munz74/HVSC_KICAD/HVSC5.stp

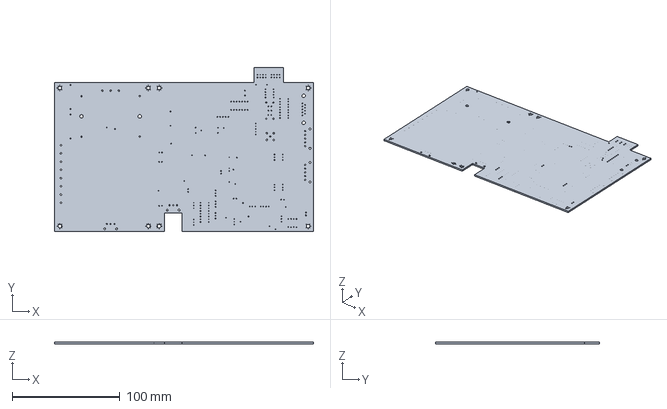
[picture p1: CAD file, 2018-07-04]
HVSC5.stp
240.0 x 152.0 x 1.60 mm
