munz74/HVSC_KICAD/HVSC5.kicad_pcb

## KiCad design HVSC5.kicad_pcb (2018-07-23)

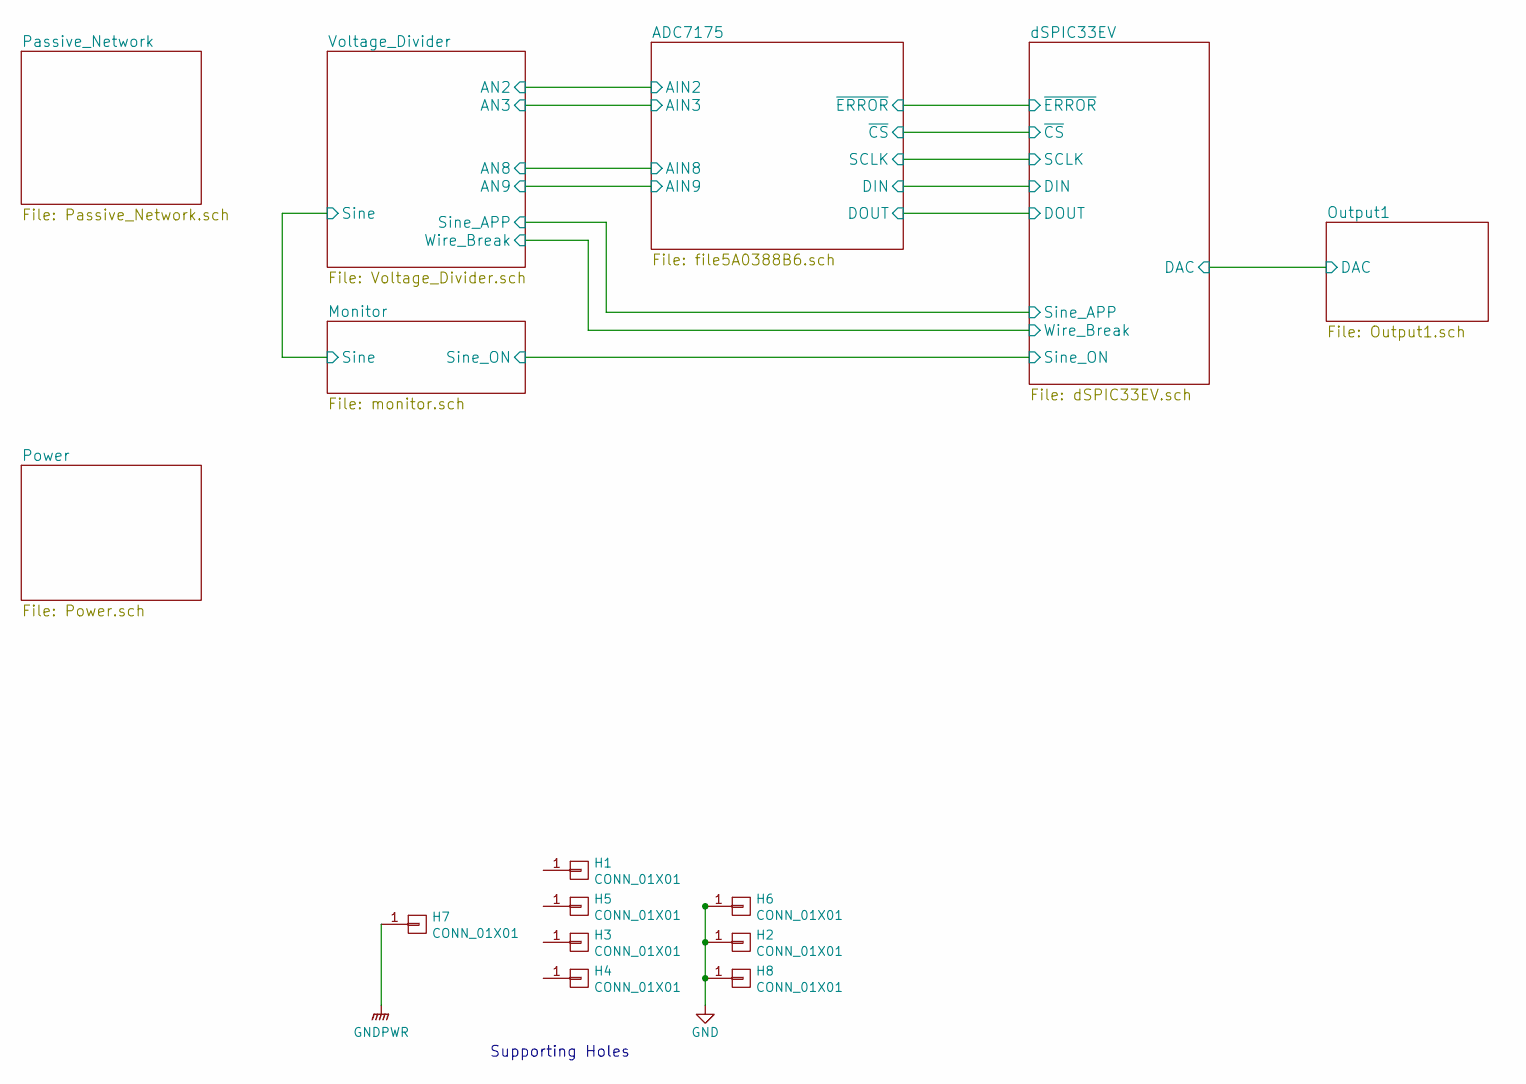
[picture p2: schematic HVSC5.sch]

Parts:
H1, H2, H3, H4, H5, H6, H7, H8: CONN_01X01; MountingHole_3.2mm_M3_Pad_Via

Connections:
GND: H2.1, H6.1, H8.1; also elsewhere on the board
GNDPWR: H7.1; also elsewhere on the board

Notes on the sheet:
Supporting Holes

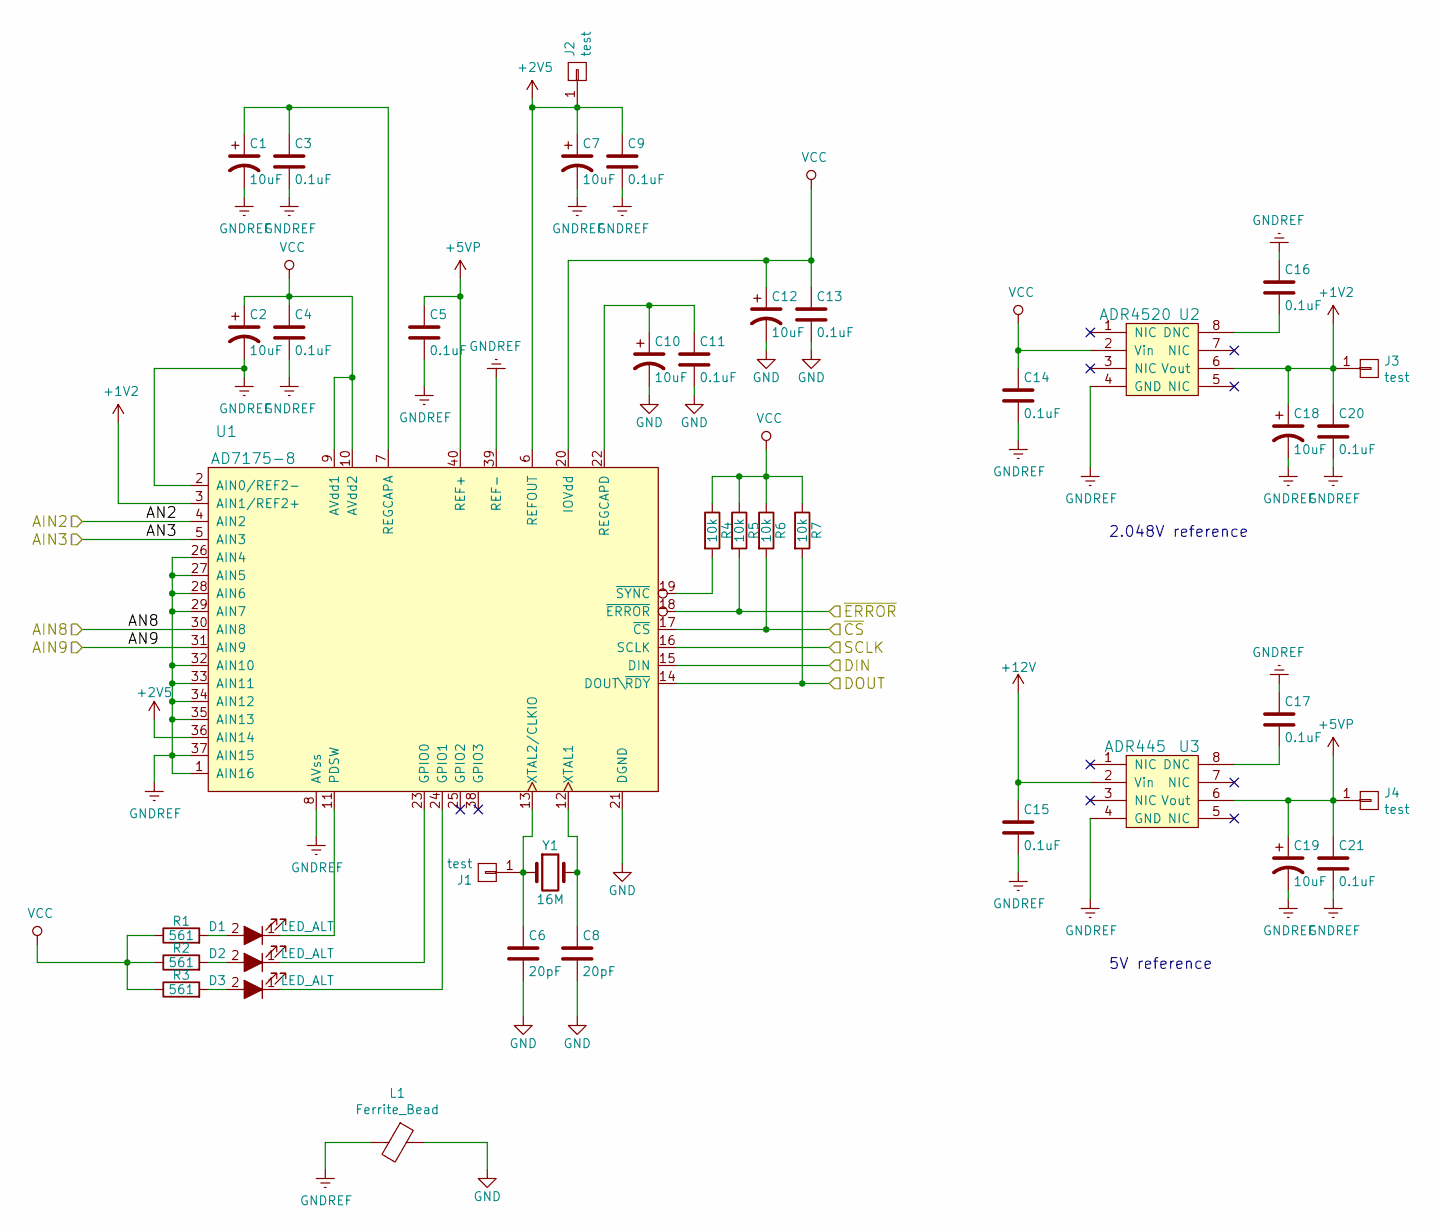
[picture p3: schematic file5A0388B6.sch]

Parts:
C1, C2, C7, C10, C12, C18, C19: 10uF; C_1812_HandSoldering_Polar
C3, C4, C5, C9, C11, C13, C14, C15, C16, C17, C20, C21: 0.1uF; C_0805_HandSoldering
C6, C8: 20pF; C_0805_HandSoldering
D1, D2, D3: LED_ALT; LED_0805_HandSoldering
J1, J2, J3, J4: test; Pin_Header_Straight_1x01_Pitch2.00mm
L1: Ferrite_Bead; L_1806_Handsoldering
R1, R2, R3: 561; R_0805_HandSoldering
R4, R5, R6, R7: 10k; R_0805_HandSoldering
U1: AD7175-8; LFCSP-40-1EP_long
U2: ADR4520; SOIC-8_3.9x4.9mm_Pitch1.27mm
U3: ADR445; SOIC-8_3.9x4.9mm_Pitch1.27mm
Y1: 16M; Crystal_HC49-4H_Vertical

Connections:
+1V2: C18.1, C20.1, J3.1, U1.3 (AIN1/REF2+), U2.6 (Vout)
+2V5: C7.1, C9.1, J2.1, U1.6 (REFOUT), U1.36 (AIN14); also elsewhere on the board
+5VP: C5.1, C19.1, C21.1, J4.1, U1.40 (REF+), U3.6 (Vout)
+12V: C15.1, U3.2 (Vin); also elsewhere on the board
/ADC7175/AIN2: U1.4 (AIN2); also elsewhere on the board
/ADC7175/AIN3: U1.5 (AIN3); also elsewhere on the board
/ADC7175/AIN8: U1.30 (AIN8); also elsewhere on the board
/ADC7175/AIN9: U1.31 (AIN9); also elsewhere on the board
/ADC7175/DIN: U1.15 (DIN); also elsewhere on the board
/ADC7175/DOUT: R7.2, U1.14 (DOUT\~RDY); also elsewhere on the board
/ADC7175/SCLK: U1.16 (SCLK); also elsewhere on the board
/ADC7175/~CS: R6.2, U1.17 (~CS); also elsewhere on the board
/ADC7175/~ERROR: R5.2, U1.18 (~ERROR); also elsewhere on the board
GND: C6.2, C8.2, C10.2, C11.2, C12.2, C13.2, L1.1, U1.21 (DGND); also elsewhere on the board
GNDREF: C1.2, C2.2, C3.2, C4.2, C5.2, C7.2, C9.2, C14.2, C15.2, C16.1, C17.1, C18.2, C19.2, C20.2, C21.2, L1.2, U1.1 (AIN16), U1.2 (AIN0/REF2-), U1.8 (AVss), U1.26 (AIN4), U1.27 (AIN5), U1.28 (AIN6), U1.29 (AIN7), U1.32 (AIN10), U1.33 (AIN11), U1.34 (AIN12), U1.35 (AIN13), U1.37 (AIN15), U1.39 (REF-), U2.4 (GND), U3.4 (GND); also elsewhere on the board
unnamed: C1.1, C3.1, U1.7 (REGCAPA)
unnamed: C6.1, J1.1, U1.13 (XTAL2/CLKIO), Y1.1
unnamed: C8.1, U1.12 (XTAL1), Y1.2
unnamed: C10.1, C11.1, U1.22 (REGCAPD)
unnamed: C16.2, U2.8 (DNC)
unnamed: C17.2, U3.8 (DNC)
unnamed: D1.1 (K), U1.11 (PDSW)
unnamed: D1.2 (A), R1.2
unnamed: D2.1 (K), U1.23 (GPIO0)
unnamed: D2.2 (A), R2.2
unnamed: D3.1 (K), U1.24 (GPIO1)
unnamed: D3.2 (A), R3.2
unnamed: R4.2, U1.19 (~SYNC)
VCC: C2.1, C4.1, C12.1, C13.1, C14.1, R1.1, R2.1, R3.1, R4.1, R5.1, R6.1, R7.1, U1.9 (AVdd1), U1.10 (AVdd2), U1.20 (IOVdd), U2.2 (Vin); also elsewhere on the board

Notes on the sheet:
5V reference
2.048V reference

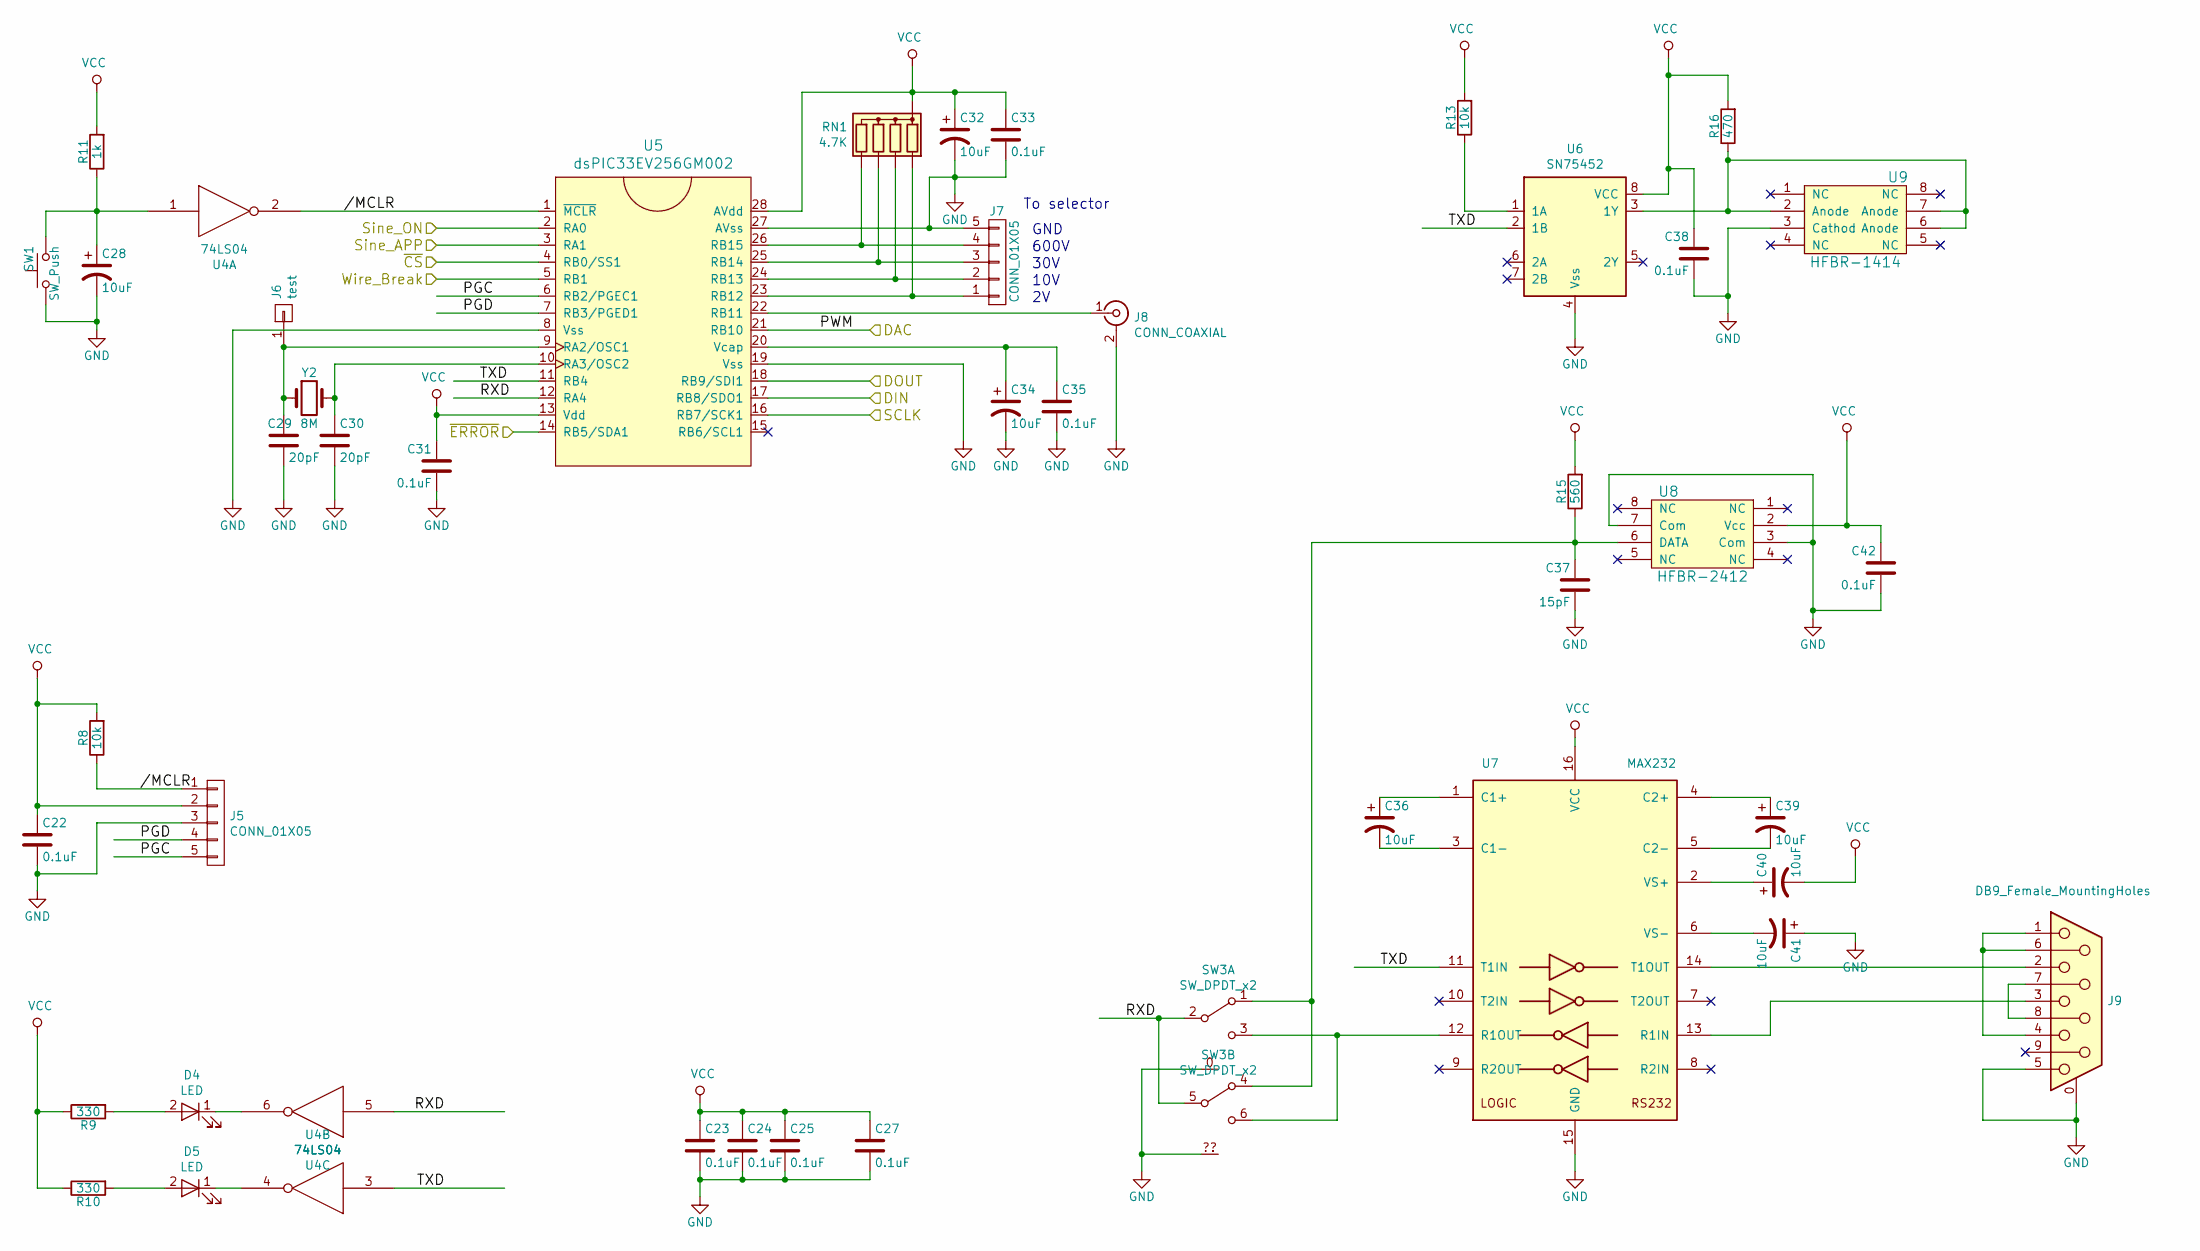
[picture p4: schematic dSPIC33EV.sch]

Parts:
C22, C23, C24, C25, C27, C31, C33, C35, C38, C42: 0.1uF; C_0805_HandSoldering
C28, C32, C34, C36, C39, C40, C41: 10uF; C_1812_HandSoldering_Polar
C29, C30: 20pF; C_0805_HandSoldering
C37: 15pF; C_0805_HandSoldering
D4, D5: LED; LED_D5.0mm
J5: CONN_01X05; Pin_Header_Straight_1x05_Pitch2.54mm
J6: test; Pin_Header_Straight_1x01_Pitch2.00mm
J7: CONN_01X05; M53259-5
J8: CONN_COAXIAL; bnc-ci
J9: DB9_Female_MountingHoles; DB_9F
R8, R13: 10k; R_0805_HandSoldering
R9, R10: 330; R_0805_HandSoldering
R11: 1k; R_0805_HandSoldering
R15: 560; R_0805_HandSoldering
R16: 470; R_Axial_DIN0207_L6.3mm_D2.5mm_P10.16mm_Horizontal
RN1: 4.7K; R_Array_SIP5
SW1: SW_Push; SW_Tactile_SPST_PTS645Vx58-2
SW3: SW_DPDT_x2; SW_E-Switch_EG2219_DPDT
U4: 74LS04; DIP-14_W7.62mm_Socket
U5: dsPIC33EV256GM002; SSOP-28_5.3x10.2mm_Pitch0.65mm
U6: SN75452; DIP-8_W7.62mm
U7: MAX232; DIP-16_W7.62mm
U8: HFBR-2412; HFBR-1414
U9: HFBR-1414
Y2: 8M; Crystal_HC49-4H_Vertical

Connections:
/ADC7175/DIN: U5.17 (RB8/SDO1); also elsewhere on the board
/ADC7175/DOUT: U5.18 (RB9/SDI1); also elsewhere on the board
/ADC7175/SCLK: U5.16 (RB7/SCK1); also elsewhere on the board
/ADC7175/~CS: U5.4 (RB0/SS1); also elsewhere on the board
/ADC7175/~ERROR: U5.14 (RB5/SDA1); also elsewhere on the board
/Monitor/Sine_ON: U5.2 (RA0); also elsewhere on the board
/Output1/DAC: U5.21 (RB10); also elsewhere on the board
/Voltage_Divider/Sine_APP: U5.3 (RA1); also elsewhere on the board
/Voltage_Divider/Wire_Break: U5.5 (RB1); also elsewhere on the board
/dSPIC33EV//MCLR: J5.1, R8.1, U4.2, U5.1 (~MCLR)
/dSPIC33EV/PGC: J5.5, U5.6 (RB2/PGEC1)
/dSPIC33EV/PGD: J5.4, U5.7 (RB3/PGED1)
/dSPIC33EV/RXD: SW3.2 (B), SW3.5 (B), U4.5, U5.12 (RA4)
/dSPIC33EV/TXD: U4.3, U5.11 (RB4), U6.2 (1B), U7.11 (T1IN)
GND: C22.2, C23.2, C24.2, C25.2, C27.2, C28.2, C29.2, C30.2, C31.2, C32.2, C33.2, C34.2, C35.2, C37.2, C38.2, C41.1, C42.2, J5.3, J7.5, J8.2 (Ext), J9.0 (PAD), J9.5, SW1.1, SW3.0 (GND), SW3.?? (GND), U4.7 (GND), U5.8 (Vss), U5.19 (Vss), U5.27 (AVss), U6.4 (Vss), U7.15 (GND), U8.3 (Com), U8.7 (Com), U9.3 (Cathod); also elsewhere on the board
unnamed: C28.1, R11.1, SW1.2, U4.1
unnamed: C29.1, J6.1, U5.9 (RA2/OSC1), Y2.1
unnamed: C30.1, U5.10 (RA3/OSC2), Y2.2
unnamed: C34.1, C35.1, U5.20 (Vcap)
unnamed: C36.1, U7.1 (C1+)
unnamed: C36.2, U7.3 (C1-)
unnamed: C37.1, R15.1, SW3.1 (A), SW3.4 (A), U8.6 (DATA)
unnamed: C39.1, U7.4 (C2+)
unnamed: C39.2, U7.5 (C2-)
unnamed: C40.1, U7.2 (VS+)
unnamed: C41.2, U7.6 (VS-)
unnamed: D4.1 (K), U4.6
unnamed: D4.2 (A), R9.2
unnamed: D5.1 (K), U4.4
unnamed: D5.2 (A), R10.2
unnamed: J7.1, RN1.2 (R1), U5.23 (RB12)
unnamed: J7.2, RN1.3 (R2), U5.24 (RB13)
unnamed: J7.3, RN1.4 (R3), U5.25 (RB14)
unnamed: J7.4, RN1.5 (R4), U5.26 (RB15)
unnamed: J8.1 (In), U5.22 (RB11)
unnamed: J9.1, J9.4, J9.6
unnamed: J9.2, U7.14 (T1OUT)
unnamed: J9.3, U7.13 (R1IN)
unnamed: J9.7, J9.8
unnamed: R13.1, U6.1 (1A)
unnamed: R16.1, U6.3 (1Y), U9.2 (Anode), U9.6 (Anode), U9.7 (Anode)
unnamed: SW3.3 (C), SW3.6 (C), U7.12 (R1OUT)
VCC: C22.1, C23.1, C24.1, C25.1, C27.1, C31.1, C32.1, C33.1, C38.1, C40.2, C42.1, J5.2, R8.2, R9.1, R10.1, R11.2, R13.2, R15.2, R16.2, RN1.1 (common), U4.14 (VCC), U5.13 (Vdd), U5.28 (AVdd), U6.8 (VCC), U7.16 (VCC), U8.2 (Vcc); also elsewhere on the board

Notes on the sheet:
To selector
600V
30V
10V
GND

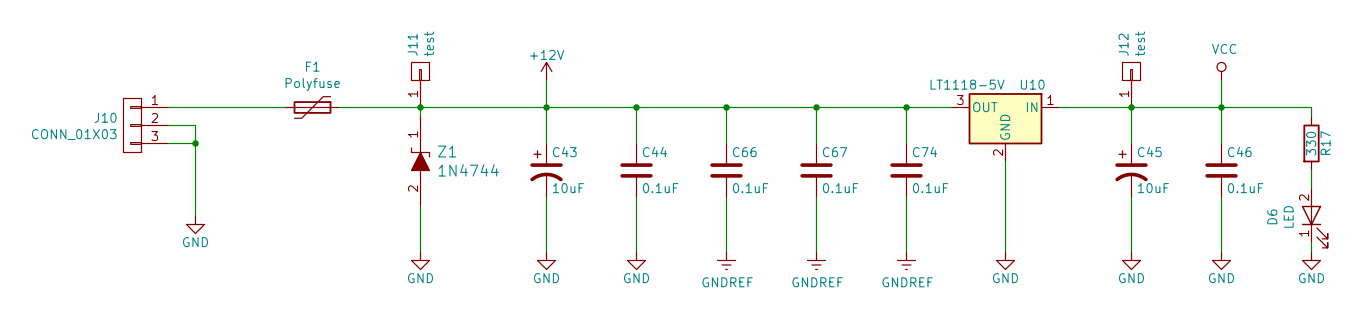
[picture p5: schematic Power.sch]

Parts:
C43, C45: 10uF; C_1812_HandSoldering_Polar
C44, C46, C66, C67, C74: 0.1uF; C_0805_HandSoldering
D6: LED; LED_D5.0mm
F1: Polyfuse; Fuse_CB61F
J10: CONN_01X03; M53259-3
J11, J12: test; Pin_Header_Straight_1x01_Pitch2.00mm
R17: 330; R_0805_HandSoldering
U10: LT1118-5V; SOT-223_LT1118
Z1: 1N4744; D_SMA-SMB_Universal_Handsoldering; MPN 1N5231BTR; Digi-Key_PN 1N5231BFSCT-ND

Connections:
+12V: C43.1, C44.1, C66.1, C67.1, C74.1, F1.1, J11.1, U10.3 (OUT), Z1.1; also elsewhere on the board
GND: C43.2, C44.2, C45.2, C46.2, D6.1 (K), J10.2, J10.3, U10.2 (GND), Z1.2; also elsewhere on the board
GNDREF: C66.2, C67.2, C74.2; also elsewhere on the board
unnamed: D6.2 (A), R17.2
unnamed: F1.2, J10.1
VCC: C45.1, C46.1, J12.1, R17.1, U10.1 (IN); also elsewhere on the board

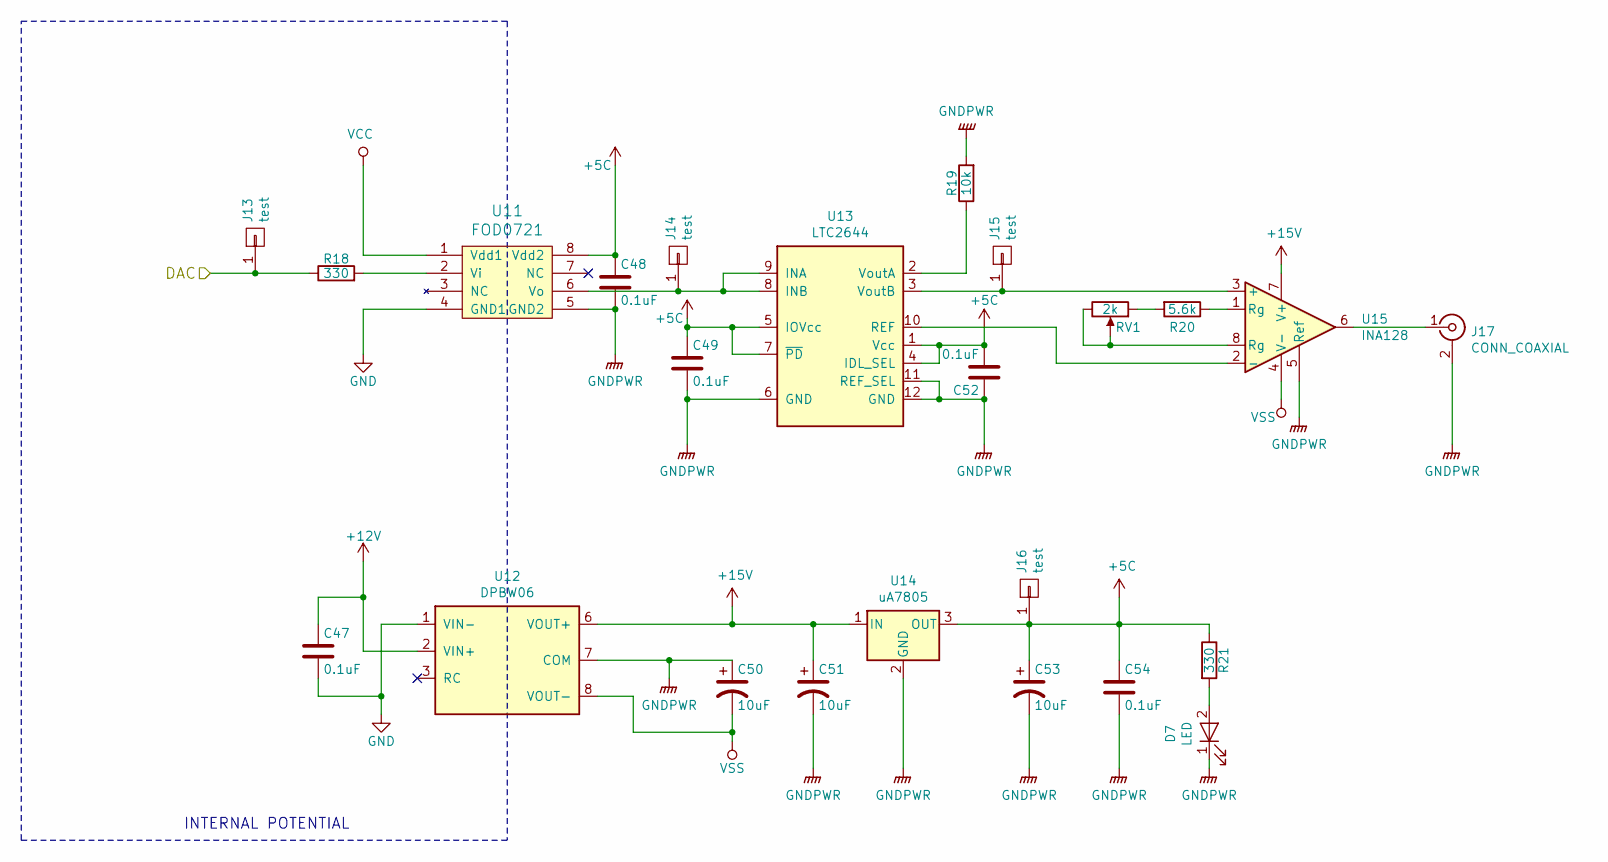
[picture p6: schematic Output1.sch]

Parts:
C47, C48, C49, C52, C54: 0.1uF; C_0805_HandSoldering
C50, C51, C53: 10uF; C_1812_HandSoldering_Polar
D7: LED; LED_D5.0mm
J13, J14, J15, J16: test; Pin_Header_Straight_1x01_Pitch2.00mm
J17: CONN_COAXIAL; Molex_KK-6410-02_02x2.54mm_Straight
R18, R21: 330; R_0805_HandSoldering
R19: 10k; R_0805_HandSoldering
R20: 5.6k; R_0805_HandSoldering
RV1: 2k; Potentiometer_Trimmer_Bourns_3296W
U11: FOD0721; SOIC-8_3.9x4.9mm_Pitch1.27mm
U12: DPBW06; DCDC-Conv_SPBW06
U13: LTC2644; MSOP-12-1EP_3x4mm_Pitch0.65mm
U14: uA7805; TO-263-2
U15: INA128; DIP-8_W7.62mm_Socket

Connections:
+12V: C47.1, U12.2 (VIN+); also elsewhere on the board
+15V: C51.1, U12.6 (VOUT+), U14.1 (IN), U15.7 (V+)
/Output1/DAC: J13.1, R18.1; also elsewhere on the board
GND: C47.2, U11.4 (GND1), U12.1 (VIN-); also elsewhere on the board
GNDPWR: C48.2, C49.2, C50.1, C51.2, C52.1, C53.2, C54.2, D7.1 (K), J17.2 (Ext), R19.2, U11.5 (GND2), U12.7 (COM), U13.6 (GND), U13.11 (REF_SEL), U13.12 (GND), U14.2 (GND), U15.5 (Ref); also elsewhere on the board
unnamed: D7.2 (A), R21.2
unnamed: J14.1, U11.6 (Vo), U13.8 (INB), U13.9 (INA)
unnamed: J15.1, U13.3 (VoutB), U15.3 (+)
unnamed: J17.1 (In), U15.6
unnamed: R18.2, U11.2 (Vi)
unnamed: R19.1, U13.2 (VoutA)
unnamed: R20.1, U15.1 (Rg)
unnamed: R20.2, RV1.1
unnamed: RV1.2, RV1.3, U15.8 (Rg)
VCC: U11.1 (Vdd1); also elsewhere on the board
VSS: C50.2, U12.8 (VOUT-), U15.4 (V-)

Notes on the sheet:
INTERNAL POTENTIAL

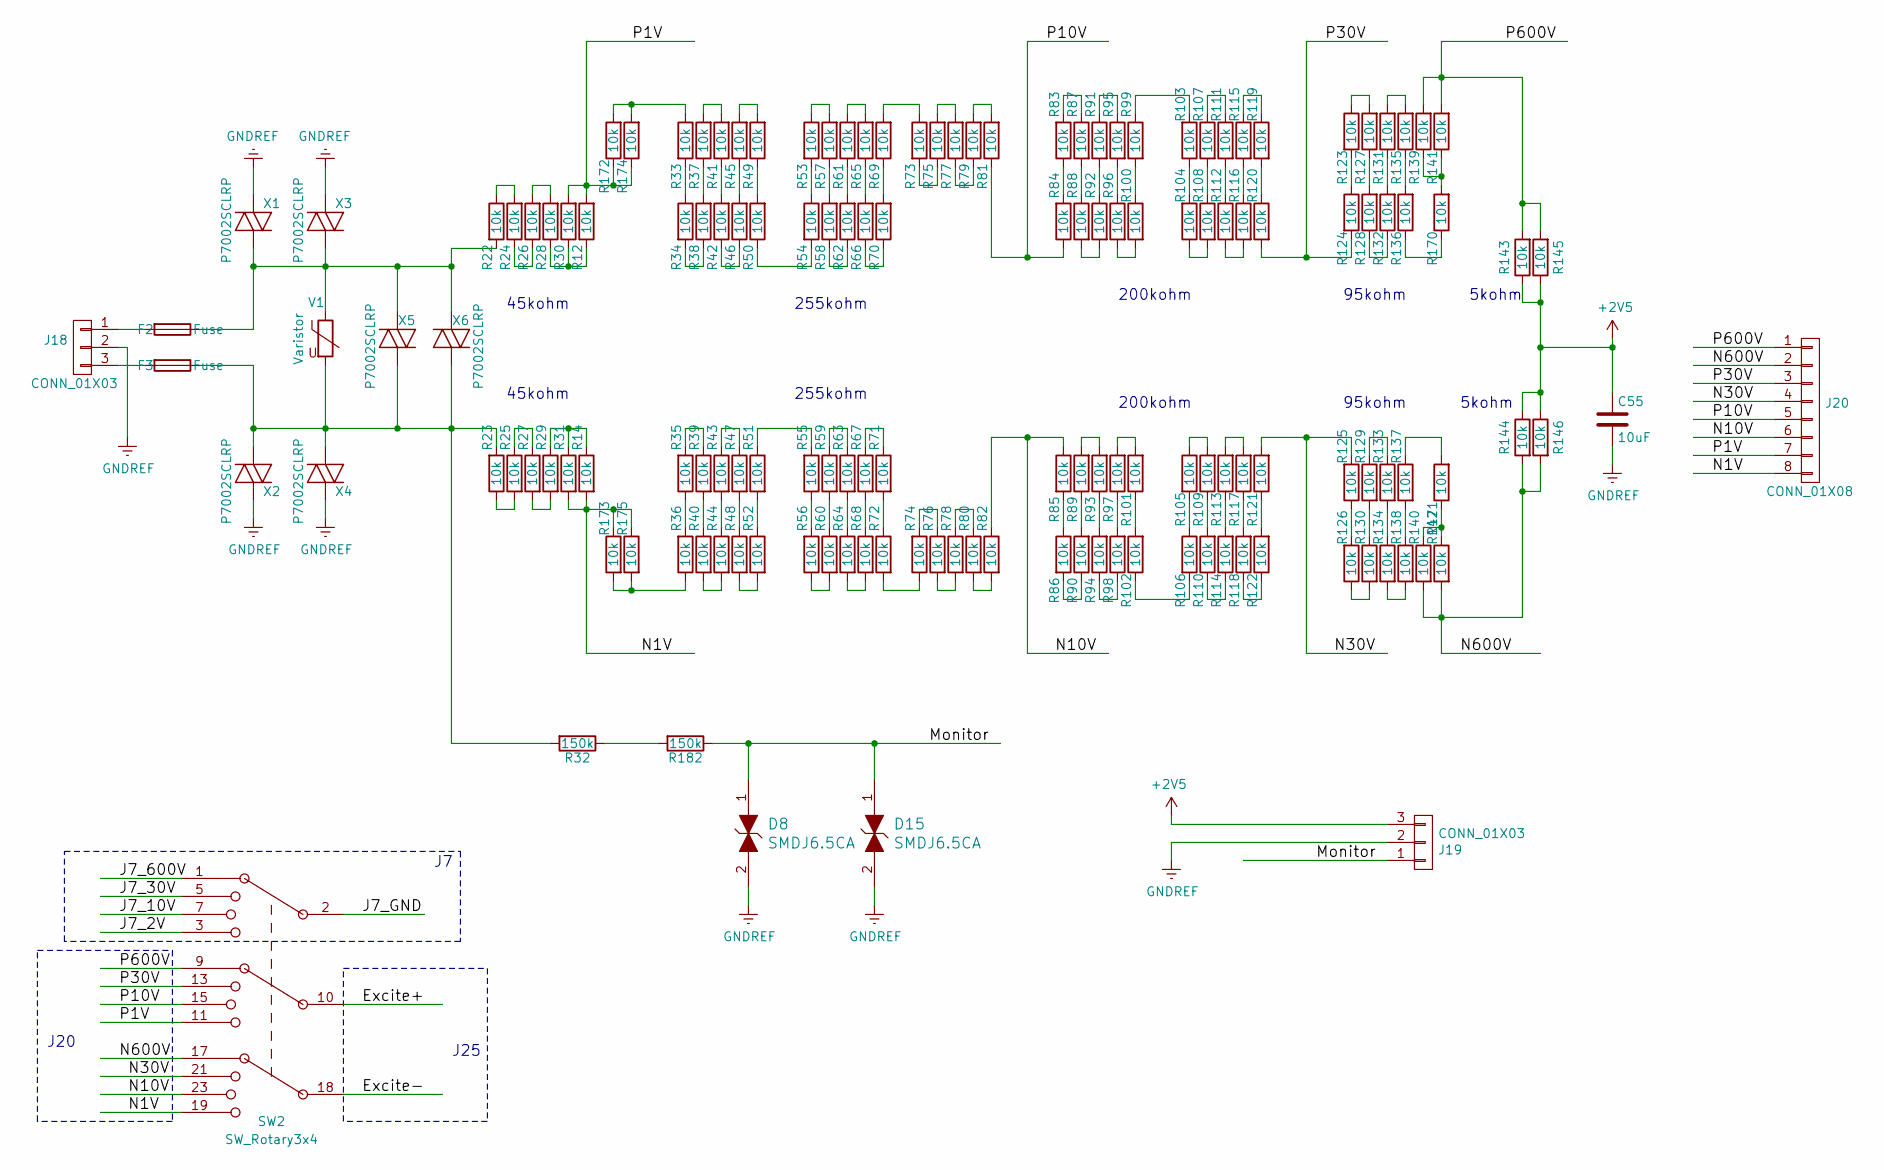
[picture p7: schematic Passive_Network.sch]

Parts:
C55: 10uF; C_1210_HandSoldering
D8, D15: SMDJ6.5CA; D_SMC_Handsoldering; MPN PGB1010603MR; Digi-Key_PN F2594CT-ND
F2, F3: Fuse; Fuseholder6x32_Horiz_Open_Schurter0031-8002
J18: CONN_01X03; BR762-3
J19: CONN_01X03; M53259-3
J20: CONN_01X08; BR762-8
R12, R14, R22, R23, R24, R25, R26, R27, R28, R29, R30, R31, R33, R34, R35, R36, R37, R38, R39, R40, R41, R42, R43, R44, R45, R46, R47, R48, R49, R50, R51, R52, R53, R54, R55, R56, R57, R58, R59, R60, R61, R62, R63, R64, R65, R66, R67, R68, R69, R70, R71, R72, R73, R74, R75, R76, R77, R78, R79, R80, R81, R82, R83, R84, R85, R86, R87, R88, R89, R90, R91, R92, R93, R94, R95, R96, R97, R98, R99, R100, R101, R102, R103, R104, R105, R106, R107, R108, R109, R110, R111, R112, R113, R114, R115, R116, R117, R118, R119, R120, R121, R122, R123, R124, R125, R126, R127, R128, R129, R130, R131, R132, R133, R134, R135, R136, R137, R138, R139, R140, R141, R142, R143, R144, R145, R146, R170, R171, R172, R173, R174, R175: 10k; R_1206_HandSoldering
R32, R182: 150k; R_Axial_Power_L20.0mm_W6.4mm_P22.40mm
SW2: SW_Rotary3x4
V1: Varistor; RV_Disc_D12_W4_P7.5
X1, X2, X3, X4, X5, X6: P7002SCLRP; D_SMA-SMB_Universal_Handsoldering

Connections:
+2V5: C55.1, J19.3, R143.1, R144.1, R145.1, R146.1; also elsewhere on the board
/Passive_Network/Monitor: D8.1, D15.1, J19.1, R182.1
/Passive_Network/N1V: J20.8, R14.2, R31.2, R173.1, R175.1, SW2.19
/Passive_Network/N10V: J20.6, R82.1, R85.1, SW2.23
/Passive_Network/N30V: J20.4, R121.2, R125.2, SW2.21
/Passive_Network/N600V: J20.2, R140.2, R142.2, R144.2, R146.2, SW2.17
/Passive_Network/P1V: J20.7, R12.2, R30.2, R172.1, R174.1, SW2.11
/Passive_Network/P10V: J20.5, R81.1, R84.1, SW2.15
/Passive_Network/P30V: J20.3, R120.2, R124.2, SW2.13
/Passive_Network/P600V: J20.1, R139.2, R141.2, R143.2, R145.2, SW2.9
GNDREF: C55.2, D8.2, D15.2, J18.2, J19.2, X1.1 (K), X2.2 (A), X3.1 (K), X4.2 (A); also elsewhere on the board
unnamed 96: F2.1, R22.2, V1.1, X1.2 (A), X3.2 (A), X5.1 (K), X6.1 (K); also elsewhere on the board
unnamed: F2.2, J18.1
unnamed: F3.1, R23.2, R32.2, V1.2, X2.1 (K), X4.1 (K), X5.2 (A), X6.2 (A)
unnamed: F3.2, J18.3
unnamed: R12.1, R28.1, R30.1
unnamed: R14.1, R29.1, R31.1
unnamed: R22.1, R24.2
unnamed: R23.1, R25.2
unnamed: R24.1, R26.1
unnamed: R25.1, R27.1
unnamed: R26.2, R28.2
unnamed: R27.2, R29.2
unnamed: R33.2, R34.1
unnamed: R34.2, R38.1
unnamed: R35.1, R36.2
unnamed: R35.2, R39.1
unnamed: R37.1, R38.2
unnamed: R37.2, R41.2
unnamed: R39.2, R40.1
unnamed: R40.2, R44.2
unnamed: R41.1, R42.2
unnamed: R42.1, R46.1
unnamed: R43.1, R47.1
unnamed: R43.2, R44.1
unnamed: R45.1, R46.2
unnamed: R45.2, R49.2
unnamed: R47.2, R48.1
unnamed: R48.2, R52.2
unnamed: R49.1, R50.2
unnamed: R50.1, R54.2
unnamed: R51.1, R55.2
unnamed: R51.2, R52.1
unnamed: R53.1, R57.2
unnamed: R53.2, R54.1
unnamed: R55.1, R56.2
unnamed: R56.1, R60.2
unnamed: R57.1, R58.2
unnamed: R58.1, R62.1
unnamed: R59.1, R63.1
unnamed: R59.2, R60.1
unnamed: R61.1, R62.2
unnamed: R61.2, R65.2
unnamed: R63.2, R64.1
unnamed: R64.2, R68.2
unnamed: R65.1, R66.2
unnamed: R66.1, R70.1
unnamed: R67.1, R71.1
unnamed: R67.2, R68.1
unnamed: R69.1, R70.2
unnamed: R69.2, R73.1
unnamed: R71.2, R72.1
unnamed: R72.2, R74.1
unnamed: R73.2, R75.1
unnamed: R74.2, R76.1
unnamed: R75.2, R77.2
unnamed: R76.2, R78.2
unnamed: R77.1, R79.1
unnamed: R78.1, R80.1
unnamed: R79.2, R81.2
unnamed: R80.2, R82.2
unnamed: R83.1, R84.2
unnamed: R83.2, R87.1
unnamed: R85.2, R86.1
unnamed: R86.2, R90.1
unnamed: R87.2, R88.1
unnamed: R88.2, R92.2
unnamed: R89.1, R90.2
unnamed: R89.2, R93.2
unnamed: R91.1, R95.1
unnamed: R91.2, R92.1
unnamed: R93.1, R94.2
unnamed: R94.1, R98.1
unnamed: R95.2, R96.1
unnamed: R97.1, R98.2
unnamed: R99.2, R100.1
unnamed: R96.2, R100.2
unnamed: R101.1, R102.2
unnamed: R97.2, R101.2
unnamed: R102.1, R106.2
unnamed: R103.1, R104.2
unnamed: R99.1, R103.2
unnamed: R104.1, R108.2
unnamed: R105.1, R109.2
unnamed: R105.2, R106.1
unnamed: R107.1, R111.1
unnamed: R107.2, R108.1
unnamed: R109.1, R110.2
unnamed: R110.1, R114.1
unnamed: R111.2, R112.1
unnamed: R112.2, R116.2
unnamed: R113.1, R114.2
unnamed: R113.2, R117.2
unnamed: R115.1, R119.1
unnamed: R115.2, R116.1
unnamed: R117.1, R118.2
unnamed: R118.1, R122.1
unnamed: R119.2, R120.1
unnamed: R121.1, R122.2
unnamed: R123.1, R127.2
unnamed: R123.2, R124.1
unnamed: R125.1, R126.2
unnamed: R126.1, R130.2
unnamed: R127.1, R128.2
unnamed: R128.1, R132.1
unnamed: R129.1, R133.1
unnamed: R129.2, R130.1
unnamed: R131.1, R132.2
unnamed: R131.2, R135.2
unnamed: R133.2, R134.1
unnamed: R134.2, R138.2
unnamed: R135.1, R136.2
unnamed: R136.1, R170.1
unnamed: R137.1, R171.2
unnamed: R137.2, R138.1
unnamed: R139.1, R141.1, R170.2
unnamed: R140.1, R142.1, R171.1
unnamed: R33.1, R172.2, R174.2
unnamed: R36.1, R173.2, R175.2
unnamed: R32.1, R182.2

Notes on the sheet:
45kohm
255kohm
200kohm
95kohm
5kohm
J20
J25

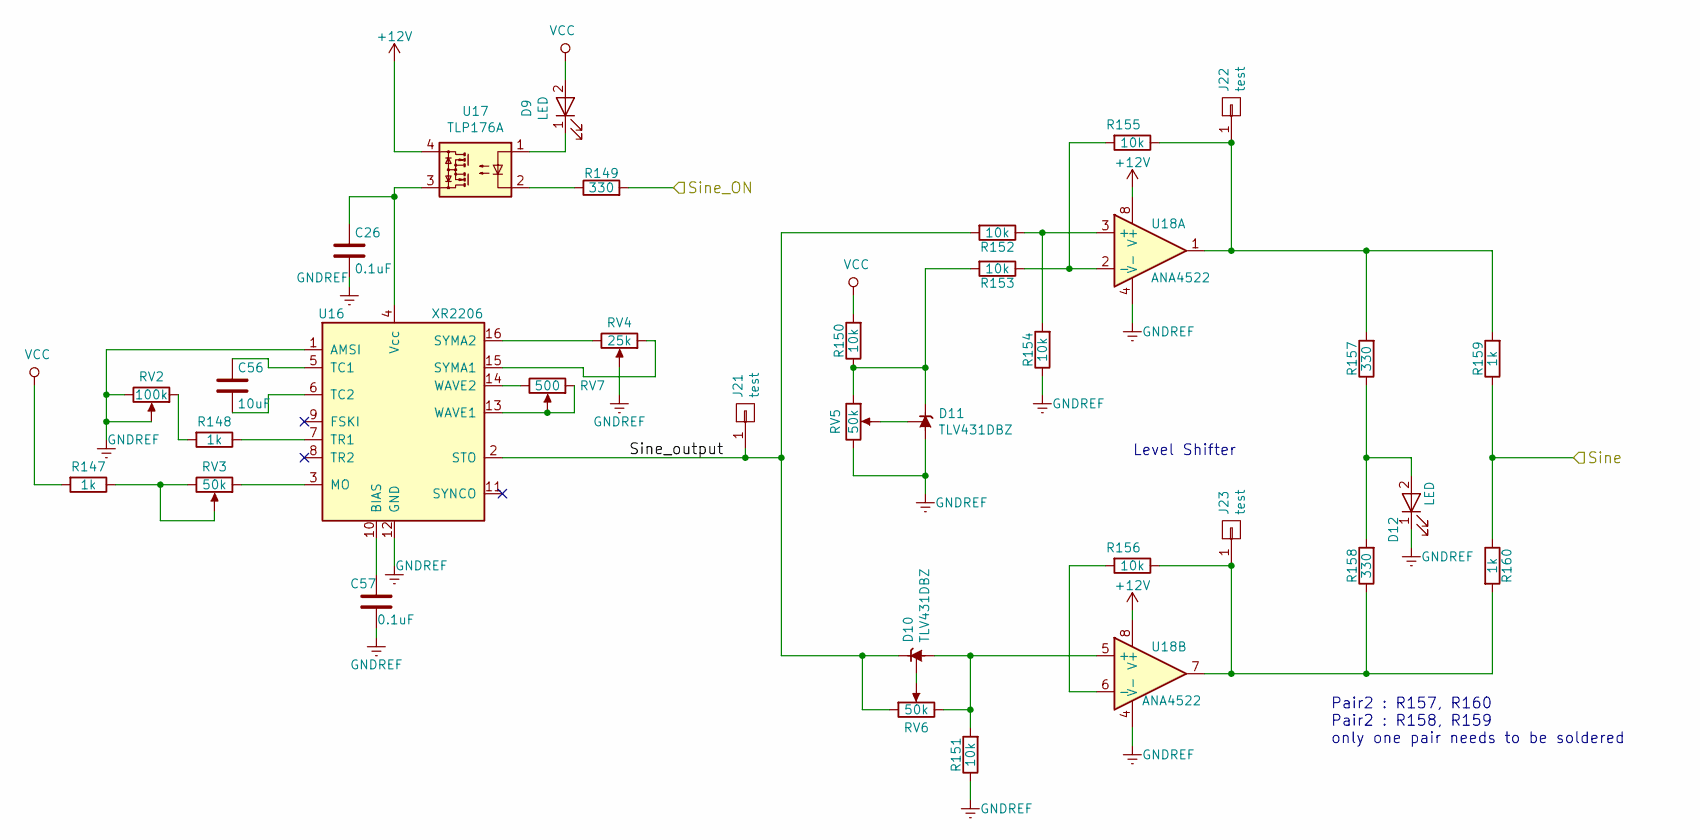
[picture p8: schematic monitor.sch]

Parts:
C26, C57: 0.1uF; C_0805_HandSoldering
C56: 10uF; C_1210_HandSoldering
D9, D12: LED; LED_D5.0mm
D10, D11: TLV431DBZ; SOT-23W_Handsoldering(LM431)
J21, J22, J23: test; Pin_Header_Straight_1x01_Pitch2.00mm
R147, R148, R159, R160: 1k; R_0805_HandSoldering
R149, R157, R158: 330; R_0805_HandSoldering
R150, R151, R152, R153, R154, R155, R156: 10k; R_0805_HandSoldering
RV2: 100k; Potentiometer_Trimmer_Bourns_3296W
RV3, RV5, RV6: 50k; Potentiometer_Trimmer_Bourns_3296W
RV4: 25k; Potentiometer_Trimmer_Bourns_3296W
RV7: 500; Potentiometer_Trimmer_Bourns_3296W
U16: XR2206; DIP-16_W7.62mm_Socket
U17: TLP176A; SO-4_4.4x4.3mm_Pitch2.54mm_Hand_Soldering
U18: ANA4522; SOIC-8_3.9x4.9mm_Pitch1.27mm

Connections:
+12V: U17.4, U18.8 (V+); also elsewhere on the board
/Monitor/Sine: R159.1, R160.1; also elsewhere on the board
/Monitor/Sine_ON: R149.2; also elsewhere on the board
/Monitor/Sine_output: D10.1 (K), J21.1, R152.2, RV6.1, U16.2 (STO)
GNDREF: C26.2, C57.2, D11.3 (A), D12.1 (K), R151.1, R154.1, RV2.2, RV2.3, RV4.2, RV5.3, U16.1 (AMSI), U16.12 (GND), U18.4 (V-); also elsewhere on the board
unnamed: C26.1, U16.4 (Vcc), U17.3
unnamed: C56.1, U16.5 (TC1)
unnamed: C56.2, U16.6 (TC2)
unnamed: C57.1, U16.10 (BIAS)
unnamed: D9.1 (K), U17.1
unnamed: D10.2 (REF), RV6.2
unnamed: D10.3 (A), R151.2, RV6.3, U18.5 (+)
unnamed: D11.1 (K), R150.1, R153.2, RV5.1
unnamed: D11.2 (REF), RV5.2
unnamed: D12.2 (A), R157.1, R158.2
unnamed: J22.1, R155.1, R157.2, R159.2, U18.1
unnamed: J23.1, R156.1, R158.1, R160.2, U18.7
unnamed: R147.1, RV3.2, RV3.3
unnamed: R148.1, U16.7 (TR1)
unnamed: R148.2, RV2.1
unnamed: R149.1, U17.2
unnamed: R152.1, R154.2, U18.3 (+)
unnamed: R153.1, R155.2, U18.2 (-)
unnamed: R156.2, U18.6 (-)
unnamed: RV3.1, U16.3 (MO)
unnamed: RV4.1, U16.15 (SYMA1)
unnamed: RV4.3, U16.16 (SYMA2)
unnamed: RV7.1, RV7.2, U16.13 (WAVE1)
unnamed: RV7.3, U16.14 (WAVE2)
VCC: D9.2 (A), R147.2, R150.2; also elsewhere on the board

Notes on the sheet:
Level Shifter
Pair2 : R157, R160 Pair2 : R158, R159 only one pair needs to be soldered
