munz74/HVSC_KICAD/HVSC5.kicad_pcb

## KiCad design HVSC5.kicad_pcb (continued)

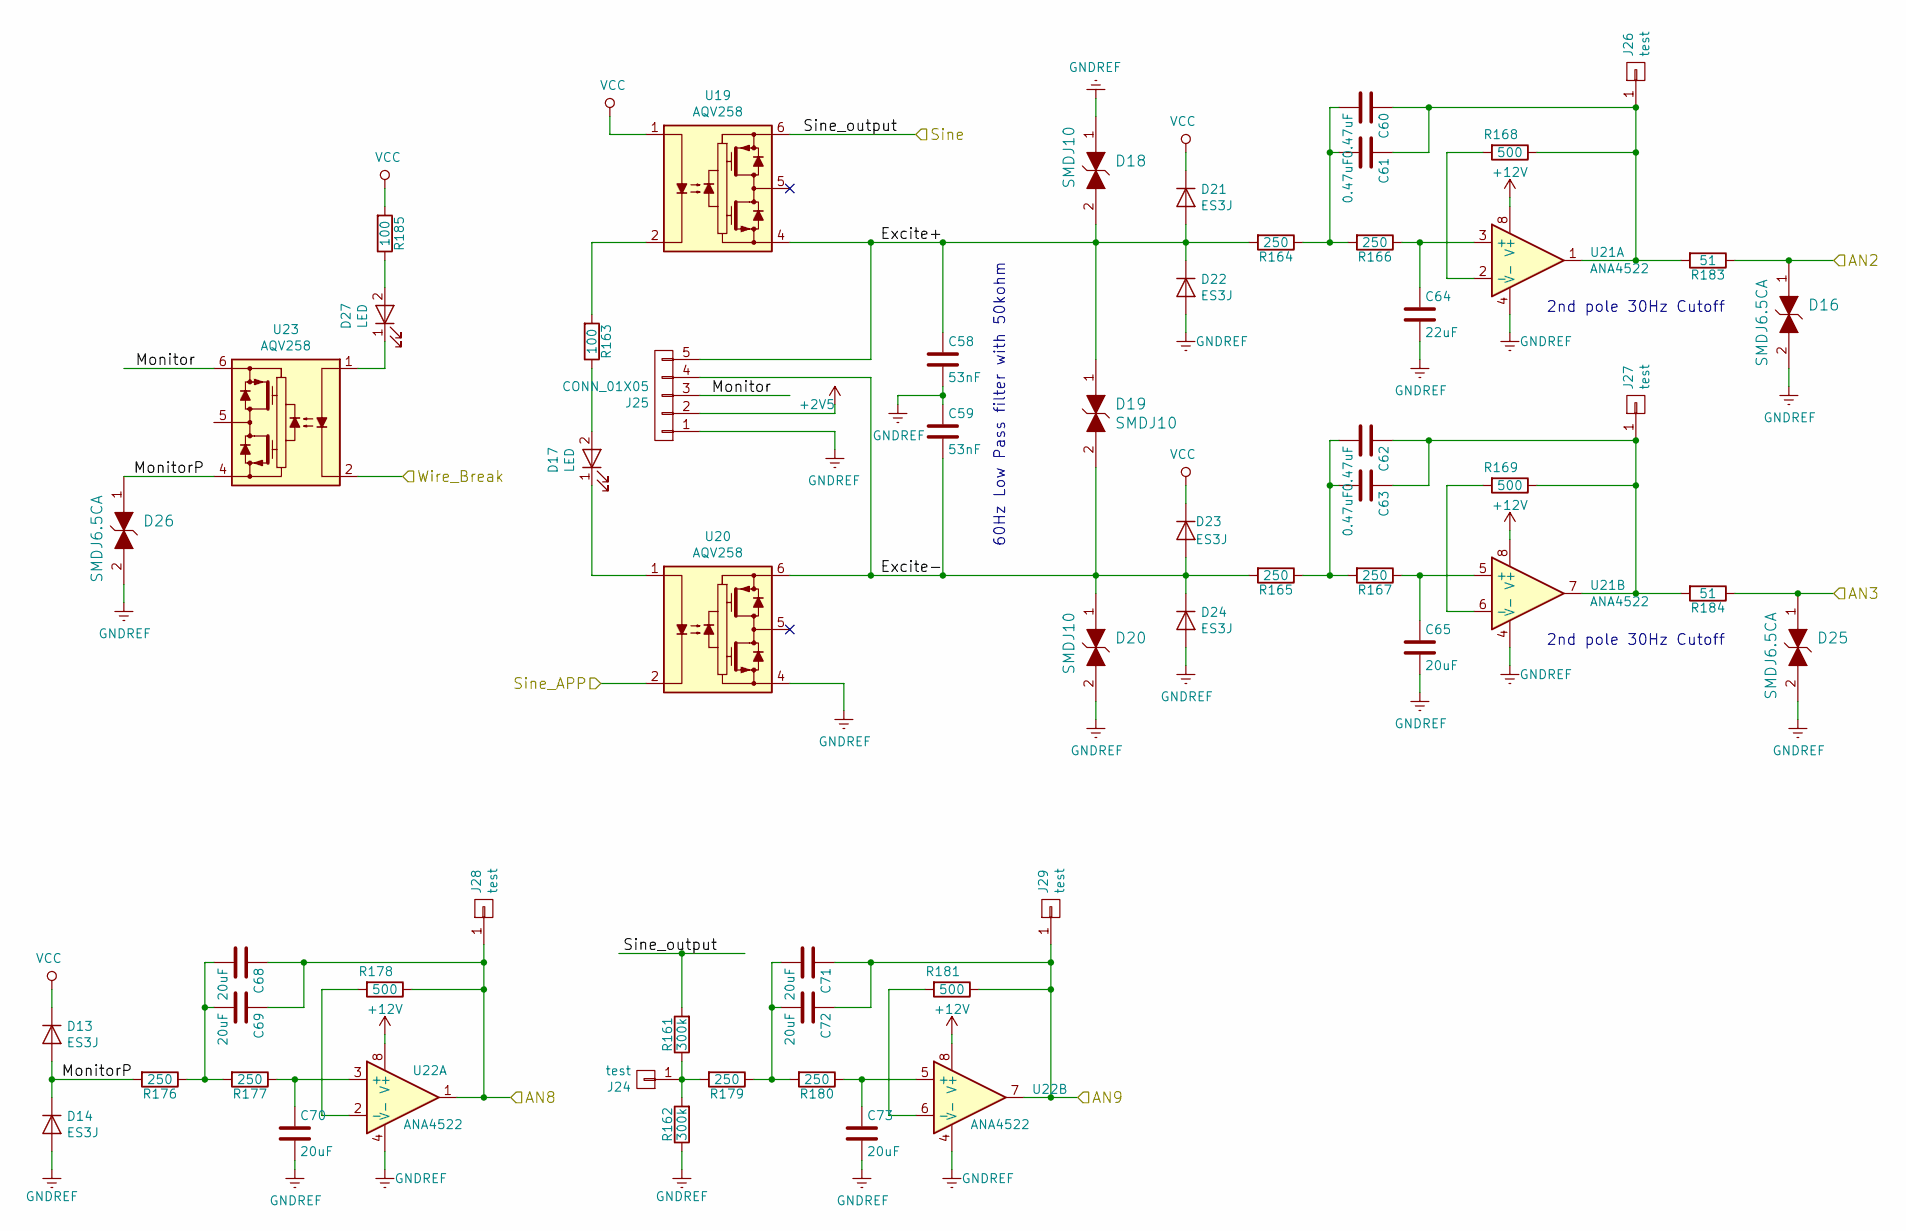
[picture p9: schematic Voltage_Divider.sch]

Parts:
C58, C59: 53nF; C_1210_HandSoldering
C60, C61, C62, C63: 0.47uF; C_1210_HandSoldering
C64: 22uF; C_1210_HandSoldering
C65, C68, C69, C70, C71, C72, C73: 20uF; C_1210_HandSoldering
D13, D14, D21, D22, D23, D24: ES3J; D_SMC_Handsoldering
D16, D25, D26: SMDJ6.5CA; D_SMC_Handsoldering; MPN PGB1010603MR; Digi-Key_PN F2594CT-ND
D17, D27: LED; LED_D5.0mm
D18, D19, D20: SMDJ10; D_SMC_Handsoldering; MPN PGB1010603MR; Digi-Key_PN F2594CT-ND
J24, J26, J27, J28, J29: test; Pin_Header_Straight_1x01_Pitch2.00mm
J25: CONN_01X05; M53259-5
R161, R162: 300k; R_Axial_DIN0207_L6.3mm_D2.5mm_P10.16mm_Horizontal
R163, R185: 100; R_0805_HandSoldering
R164, R165, R166, R167, R176, R177, R179, R180: 250; R_0805_HandSoldering
R168, R169, R178, R181: 500; R_0805_HandSoldering
R183, R184: 51; R_0805_HandSoldering
U19, U20, U23: AQV258; DIP-6_W7.62mm_Socket
U21, U22: ANA4522; SOIC-8_3.9x4.9mm_Pitch1.27mm

Connections:
+2V5: J25.2; also elsewhere on the board
+12V: U21.8 (V+), U22.8 (V+); also elsewhere on the board
/ADC7175/AIN2: D16.1, R183.1; also elsewhere on the board
/ADC7175/AIN3: D25.1, R184.1; also elsewhere on the board
/ADC7175/AIN8: C68.1, C69.1, J28.1, R178.1, U22.1; also elsewhere on the board
/ADC7175/AIN9: C71.1, C72.1, J29.1, R181.1, U22.7; also elsewhere on the board
/Monitor/Sine: R161.2, U19.6 (VCC); also elsewhere on the board
/Voltage_Divider/Excite+: C58.1, D18.2, D19.1, D21.2 (A), D22.1 (K), J25.5, R164.2, U19.4 (VEE)
/Voltage_Divider/Excite-: C59.2, D19.2, D20.1, D23.2 (A), D24.1 (K), J25.4, R165.2, U20.6 (VCC)
/Voltage_Divider/Monitor: J25.3, U23.6 (VCC)
/Voltage_Divider/MonitorP: D13.2 (A), D14.1 (K), D26.1, R176.2, U23.4 (VEE)
/Voltage_Divider/Sine_APP: U20.2 (C); also elsewhere on the board
/Voltage_Divider/Wire_Break: U23.2 (C); also elsewhere on the board
GNDREF: C58.2, C59.1, C64.2, C65.2, C70.2, C73.2, D14.2 (A), D16.2, D18.1, D20.2, D22.2 (A), D24.2 (A), D25.2, D26.2, J25.1, R162.1, U20.4 (VEE), U21.4 (V-), U22.4 (V-); also elsewhere on the board
unnamed: C60.1, C61.1, J26.1, R168.1, R183.2, U21.1
unnamed: C60.2, C61.2, R164.1, R166.2
unnamed: C62.1, C63.1, J27.1, R169.1, R184.2, U21.7
unnamed: C62.2, C63.2, R165.1, R167.2
unnamed: C64.1, R166.1, U21.3 (+)
unnamed: C65.1, R167.1, U21.5 (+)
unnamed: C68.2, C69.2, R176.1, R177.2
unnamed: C70.1, R177.1, U22.3 (+)
unnamed: C71.2, C72.2, R179.1, R180.2
unnamed: C73.1, R180.1, U22.5 (+)
unnamed: D17.1 (K), U20.1 (A)
unnamed: D17.2 (A), R163.1
unnamed: D27.1 (K), U23.1 (A)
unnamed: D27.2 (A), R185.1
unnamed: J24.1, R161.1, R162.2, R179.2
unnamed: R163.2, U19.2 (C)
unnamed: R168.2, U21.2 (-)
unnamed: R169.2, U21.6 (-)
unnamed: R178.2, U22.2 (-)
unnamed: R181.2, U22.6 (-)
VCC: D13.1 (K), D21.1 (K), D23.1 (K), R185.2, U19.1 (A); also elsewhere on the board

Notes on the sheet:
2nd pole 30Hz Cutoff
60Hz Low Pass filter with 50kohm

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
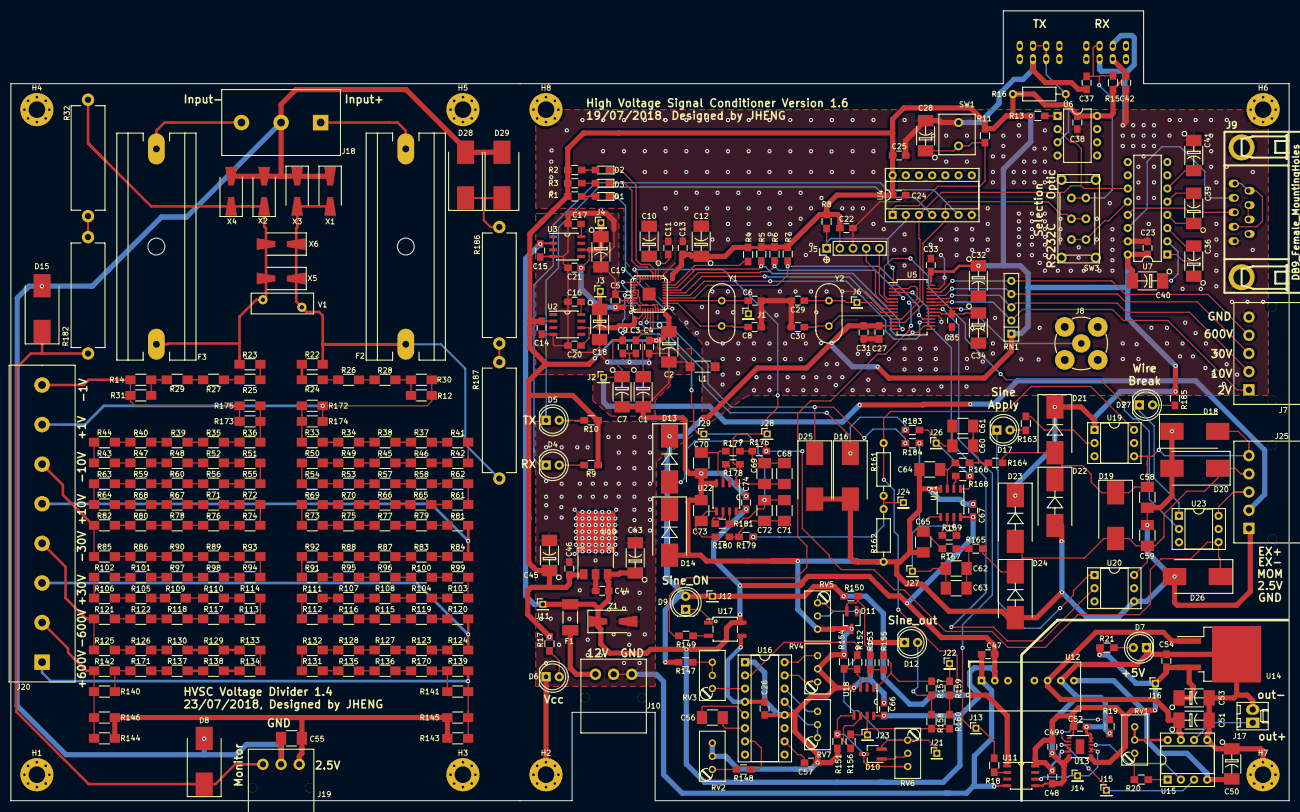
[picture p10: board HVSC5.kicad_pcb from above]

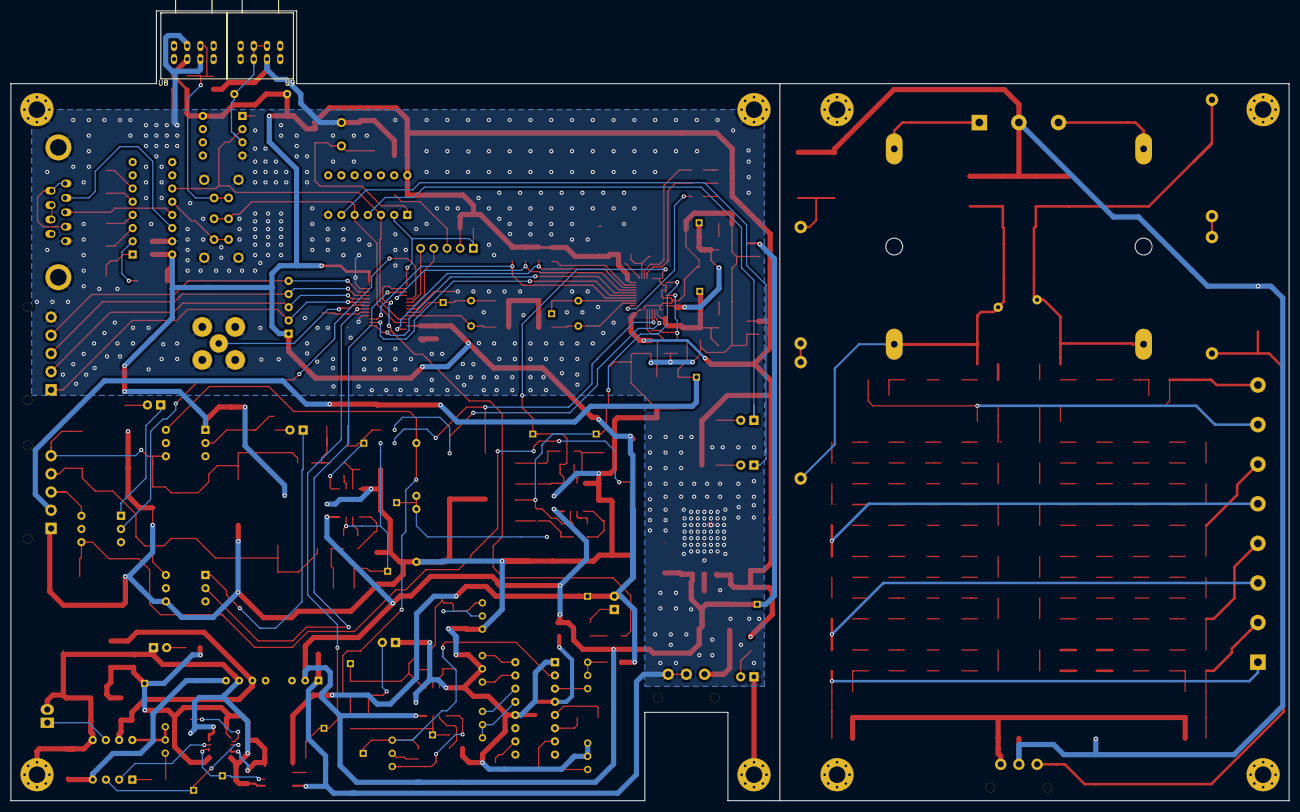
[picture p11: board HVSC5.kicad_pcb from below]

Board: 2 copper layers, 246.0 x 152.0 mm, 374 parts (2 on the bottom side), 261 nets.

Other parts of the board:
D28, D29: SMDJ11CA; D_SMC_Handsoldering
R186, R187: 150k; R_Axial_Power_L20.0mm_W6.4mm_P22.40mm

Their connections:
GNDREF: D28.2, D29.2; also elsewhere on the board
unnamed: D28.1, D29.1, R186.2
unnamed 96: R187.1; also elsewhere on the board
unnamed: R186.1, R187.2
