munz74/HVSC_KICAD/(commit log)

2018-06-06 2차 PCB
    2차 PCB 발주 버전 에서 아주 조금 수정한것
    [Active_Filter.sch, HVSC5.kicad_pcb, HVSC5.sch, Output1.sch, Passive_Network.sch, Power.sch, Power1.sch, Signal.sch]
2018-06-06 Small_Change
    시험삼아서 수정하였음
    [HVSC5.kicad_pcb]
2018-06-06 저항값설정
    저항값 1차 설정
    [dSPIC33EV.sch, monitor.sch]
2018-06-07 Soldering sequence
    솔더링 순서
    1st CPU PW ADC
    2nd Filter
    3rd DAC out
    4th Sine generator
    5th Voltage divider & protection
    [HVSC5.sch]
2018-06-08 전해콘덴서 foot print 변경
    전해 콘덴서 변경
    Bypass 콘데서 OPAMP에 추가 하여야 함
    [HVSC5.kicad_pcb, Output1.sch, Passive_Network.sch, Power.sch, dSPIC33EV.sch, file5A0388B6.sch, monitor.sch]
2018-06-11 2차 PCB 1차 수정
    1. ADR455 Vcc V12 수정
    2. DCDC 입력전압 변경
    3. Bypass 콘덴서 C66, C67 추가
    4. SOIC 방향 표시
    5. TLV431 PADS 변경
    6. AQV258 Pin3 --> Pin2
    7. 전해콘덴서 방향추가
    [HVSC5.kicad_pcb, Output1.sch, Passive_Network.sch, Power.sch, Voltage_Divider.sch, file5A0388B6.sch, monitor.sch]
2018-06-12 switch 수정
    [HVSC5.kicad_pcb, dSPIC33EV.sch, file5A0388B6.sch]
2018-06-12 Selector 표시
    [Passive_Network.sch]
2018-06-14 Selector Numbering
    Selector numbering
    [HVSC5.kicad_pcb, Passive_Network.sch, dSPIC33EV.sch, monitor.sch]
2018-06-18 0805_넓히기
    기타 수정
    [HVSC5.kicad_pcb, Output1.sch, Passive_Network.sch, Power.sch, Voltage_Divider.sch, dSPIC33EV.sch]
2018-06-18 1206 update
    다시 보세요.
    [HVSC5.kicad_pcb, Passive_Network.sch]
2018-06-22 2차PCB
    U22 포함
    [HVSC5-B.CrtYd.gbr, HVSC5-B.Cu.gbr, HVSC5-B.Mask.gbr, HVSC5-B.Paste.gbr, HVSC5-B.SilkS.gbr, HVSC5-Edge.Cuts.gbr, HVSC5-F.CrtYd.gbr, HVSC5-F.Cu.gbr]
2018-07-04 High Voltage reinforce
    고전압 부분 보강
    AN2, AN3 두 부분 6.5V limit
    [HVSC5.kicad_pcb, HVSC5.stp, Passive_Network.sch, Voltage_Divider.sch]
2018-07-13 3차 PCB
    1. 모니터 고압부 150k옴 2갤로 수정
    2. 6.5V Zener 추가
    [HVSC5-B.CrtYd.gbr, HVSC5-B.Cu.gbr, HVSC5-B.Mask.gbr, HVSC5-B.Paste.gbr, HVSC5-B.SilkS.gbr, HVSC5-Edge.Cuts.gbr, HVSC5-F.CrtYd.gbr, HVSC5-F.Cu.gbr]
2018-07-16 PCB Part name
    PCB Part name 수정
    [Passive_Network.sch]
2018-07-19 4차 PCB
    U23 Wire Breakage Relay 추가
    [HVSC5.kicad_pcb, HVSC5.sch, Passive_Network.sch, Voltage_Divider.sch, dSPIC33EV.sch, monitor.sch]
2018-07-23 Balanced Resistor 추가
    D28 D29, R186, R187 추가
    [HVSC5-B.CrtYd.gbr, HVSC5-B.Cu.gbr, HVSC5-B.Mask.gbr, HVSC5-B.Paste.gbr, HVSC5-B.SilkS.gbr, HVSC5-Edge.Cuts.gbr, HVSC5-F.CrtYd.gbr, HVSC5-F.Cu.gbr]
